adamaq01/processi/(commit log)

2023-05-08 Fix state register flags order
    [state_register.vhd]
2023-05-11 Add pin planning for Quartus fit project
2023-05-11 Fix top level and add test
    [run_tests.py, tests_5.vhd, top_level.vhd]
2023-05-11 Fix bit order for 7 segments
    [tests_5.vhd, top_level.vhd]
